feshie/sensors/README.md

sensors
=======
These feshie smarft sensors use an MCU (AVR) to interface to the actual sensors - and provide protocol buffer formatted data
