feshie/sensors/code/OneWire/README.md

Code from:
http://www.hacktronics.com/Tutorials/arduino-1-wire-tutorial.html
