feshie/sensors/pcbs/analog-interface.brd

## EAGLE design pcbs/analog-interface.brd (2014-09-02)

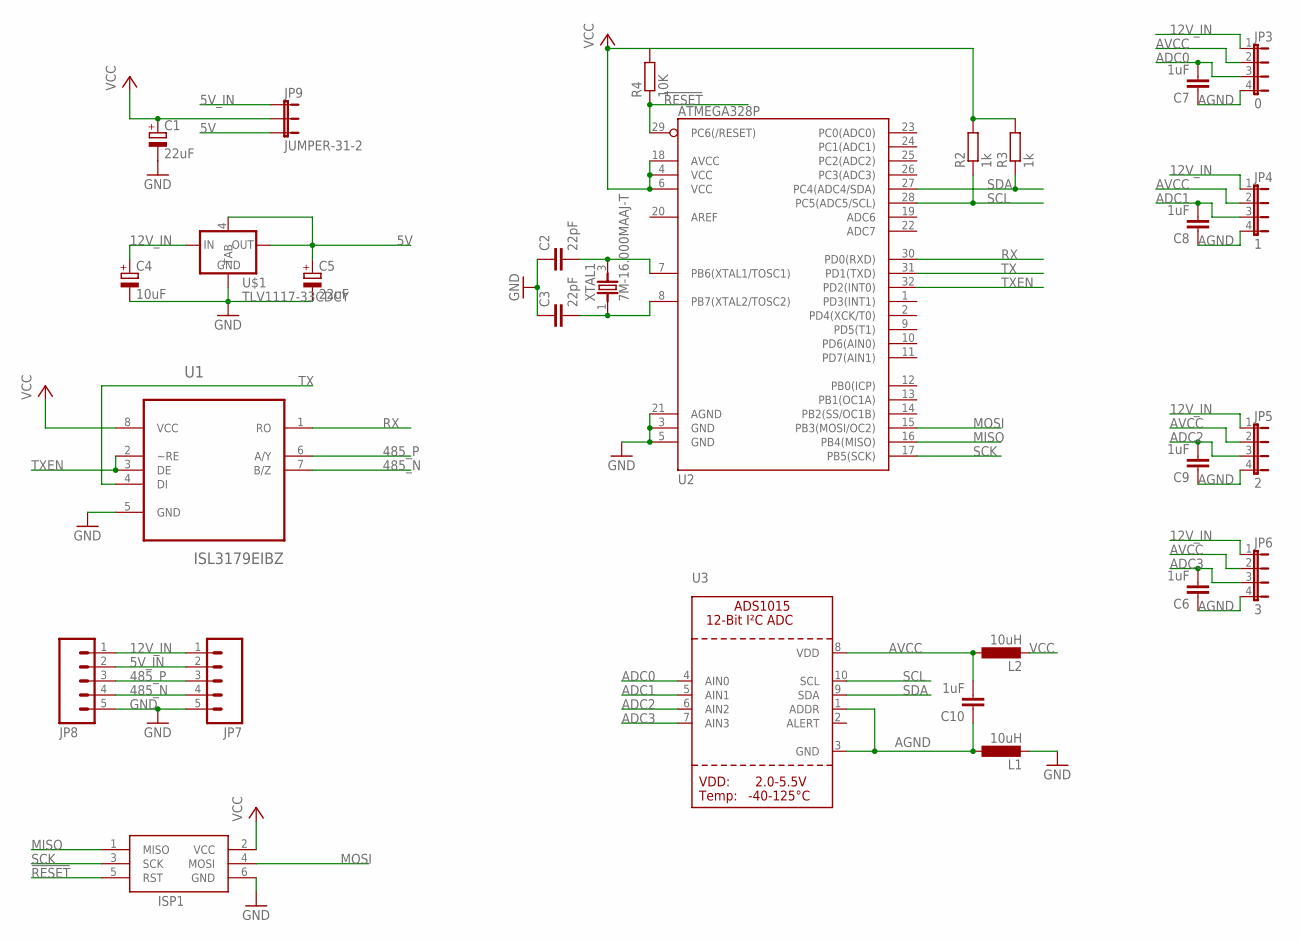
[picture p1: schematic analog-interface.sch]

Parts:
C1, C5: 22uF; A/3216-18R
C2, C3: 22pF; C0805
C4: 10uF; A/3216-18R
C6, C7, C8, C9, C10: 1uF; C0805
ISP1: AVRISP-6; AVRISP
JP3: 0; JP4
JP4: 1; JP4
JP5: 2; JP4
JP6: 3; JP4
JP7, JP8: M05PTH; 1X05
JP9: JUMPER-31-2; SJ_3_PASTE1&2
L1, L2: 10uH; L3216C
R2, R3: 1k; R0805
R4: 10K; R0805
U1: ISL3179EIBZ; SOIC127P600X175-8N
U2: ATMEGA328P; TQFP32-08
U3: ADC_ADS1015; MSOP10
U$1: TLV1117-33CDCY; SOT223
XTAL1: 7M-16.000MAAJ-T; TXC_7M-16.000MAAJ-T

Connections:
5V: C5.+, JP9.3, U$1.2 (OUT), U$1.4 (TAB)
5V_IN: JP7.2, JP8.2, JP9.1
12V_IN: C4.+, JP3.1, JP4.1, JP5.1, JP6.1, JP7.1, JP8.1, U$1.3 (IN)
485_N: JP7.4, JP8.4, U1.7 (B/Z)
485_P: JP7.3, JP8.3, U1.6 (A/Y)
!RESET: ISP1.5 (RST), R4.1, U2.29 (PC6(/RESET))
ADC0: C7.2, JP3.3, U3.4 (AIN0)
ADC1: C8.2, JP4.3, U3.5 (AIN1)
ADC2: C9.2, JP5.3, U3.6 (AIN2)
ADC3: C6.2, JP6.3, U3.7 (AIN3)
AGND: C6.1, C7.1, C8.1, C9.1, C10.1, JP3.4, JP4.4, JP5.4, JP6.4, L1.1, U3.1 (ADDR), U3.3 (GND)
AVCC: C10.2, JP3.2, JP4.2, JP5.2, JP6.2, L2.1, U3.8 (VDD)
GND: C1.-, C2.1, C3.1, C4.-, C5.-, ISP1.6 (GND), JP7.5, JP8.5, L1.2, U1.5 (GND), U2.3 (GND), U2.5 (GND), U2.21 (AGND), U$1.1 (GND)
MISO: ISP1.1 (MISO), U2.16 (PB4(MISO))
MOSI: ISP1.4 (MOSI), U2.15 (PB3(MOSI/OC2))
unnamed: C2.2, U2.7 (PB6(XTAL1/TOSC1)), XTAL1.3
unnamed: C3.2, U2.8 (PB7(XTAL2/TOSC2)), XTAL1.1
RX: U1.1 (RO), U2.30 (PD0(RXD))
SCK: ISP1.3 (SCK), U2.17 (PB5(SCK))
SCL: R2.1, U2.28 (PC5(ADC5/SCL)), U3.10 (SCL)
SDA: R3.1, U2.27 (PC4(ADC4/SDA)), U3.9 (SDA)
TX: U1.4 (DI), U2.31 (PD1(TXD))
TXEN: U1.2 (~RE), U1.3 (DE), U2.32 (PD2(INT0))
VCC: C1.+, ISP1.2 (VCC), JP9.2, L2.2, R2.2, R3.2, R4.2, U1.8 (VCC), U2.4 (VCC), U2.6 (VCC), U2.18 (AVCC)

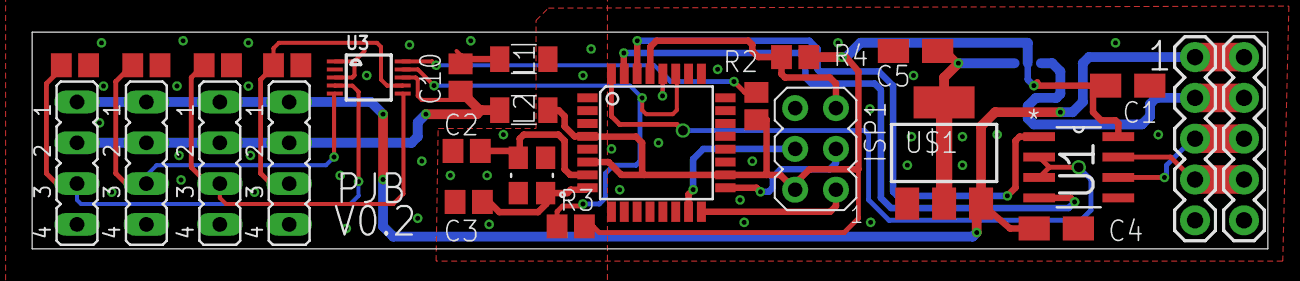
[picture p2: board analog-interface.brd from above]

Board: 2 copper layers, 76.9 x 13.5 mm, 28 parts (1 on the bottom side), 24 nets.
