feshie/sensors/pcbs/temp-accel-chain.brd

## EAGLE design pcbs/temp-accel-chain.brd (2014-07-10)

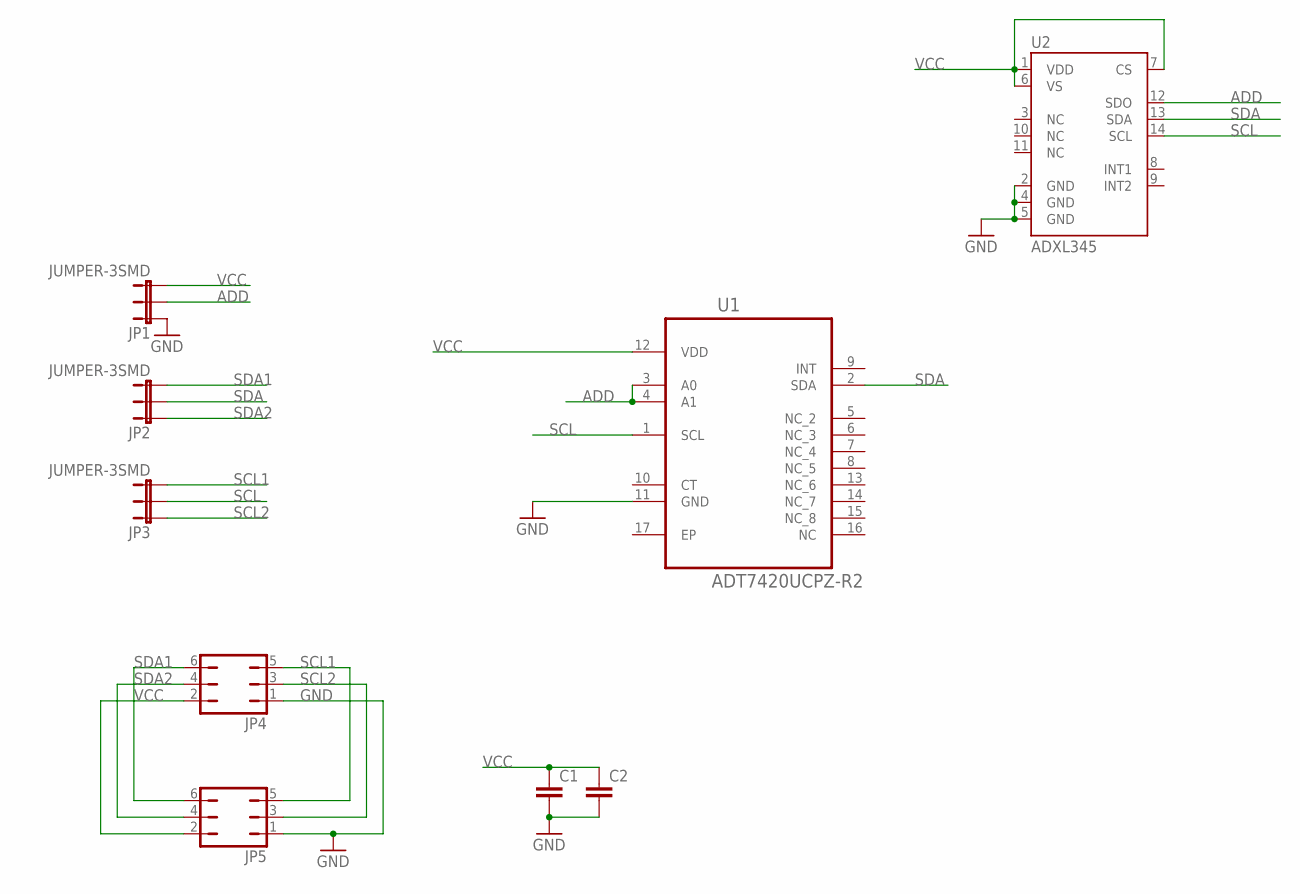
[picture p3: schematic temp-accel-chain.sch]

Parts:
C1, C2: C-EUC0805; C0805
JP1, JP2, JP3: JUMPER-3SMD; SJ_3
JP4, JP5: JP3Q
U1: ADT7420UCPZ-R2; QFN65P400X400X80-17N
U2: ADXL345; LGA14

Connections:
ADD: JP1.2, U1.3 (A0), U1.4 (A1), U2.12 (SDO)
GND: C1.2, C2.2, JP1.1, JP4.1, JP5.1, U1.11 (GND), U2.2 (GND), U2.4 (GND), U2.5 (GND)
SCL: JP3.2, U1.1 (SCL), U2.14 (SCL)
SCL1: JP3.3, JP4.5, JP5.5
SCL2: JP3.1, JP4.3, JP5.3
SDA: JP2.2, U1.2 (SDA), U2.13 (SDA)
SDA1: JP2.3, JP4.6, JP5.6
SDA2: JP2.1, JP4.4, JP5.4
VCC: C1.1, C2.1, JP1.3, JP4.2, JP5.2, U1.12 (VDD), U2.1 (VDD), U2.6 (VS), U2.7 (CS)

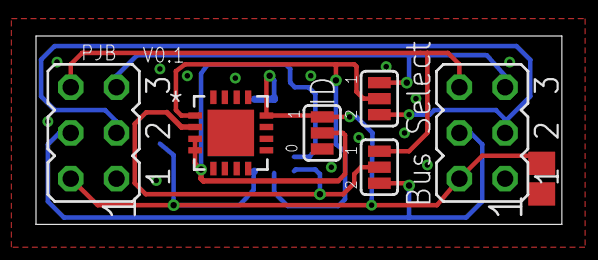
[picture p4: board temp-accel-chain.brd from above]

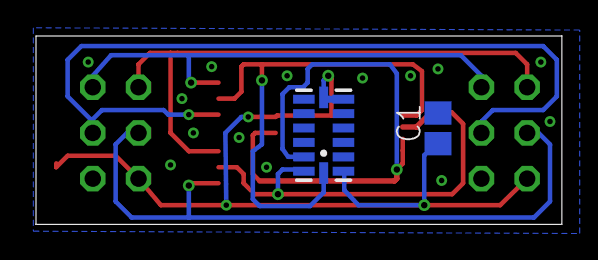
[picture p5: board temp-accel-chain.brd from below]

Board: 2 copper layers, 29.2 x 10.5 mm, 9 parts (2 on the bottom side), 9 nets.
