feshie/sensors/pcbs/mpx4115-breakout-throughhole.brd

## EAGLE design pcbs/mpx4115-breakout-throughhole.brd (2014-07-01)

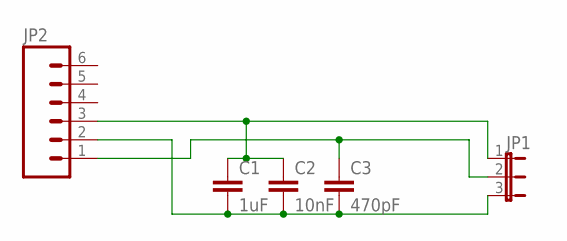
[picture p6: schematic mpx4115-breakout-throughhole.sch]

Parts:
C1: 1uF; C0805
C2: 10nF; C0805
C3: 470pF; C0805
JP1: JP2E; JP2
JP2: M06NO_SILK; 1X06_NO_SILK

Connections:
GND: C1.2, C2.2, C3.2, JP2.2
VCC: C1.1, C2.1, JP1.1, JP2.3
VOUT: C3.1, JP1.2, JP2.1

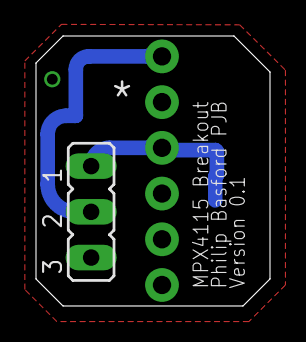
[picture p7: board mpx4115-breakout-throughhole.brd from above]

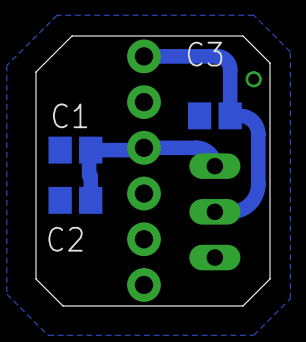
[picture p8: board mpx4115-breakout-throughhole.brd from below]

Board: 2 copper layers, 13.0 x 15.0 mm, 5 parts (3 on the bottom side), 3 nets.
