feshie/sensors/pcbs/mpx4115-breakout.brd

## EAGLE design pcbs/mpx4115-breakout.brd (2014-06-12)

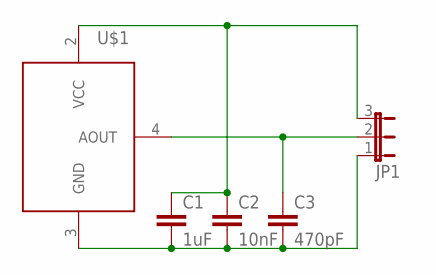
[picture p9: schematic mpx4115-breakout.sch]

Parts:
C1: 1uF; C0805
C2: 10nF; C0805
C3: 470pF; C0805
JP1: JP2E; JP2
U$1: MPX4115A

Connections:
AOUT: C3.1, JP1.2, U$1.4 (AOUT)
GND: C1.2, C2.2, C3.2, JP1.1, U$1.3 (GND)
VCC: C1.1, C2.1, JP1.3, U$1.2 (VCC)

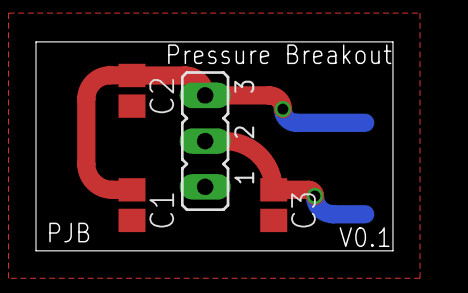
[picture p10: board mpx4115-breakout.brd from above]

Board: 2 copper layers, 19.8 x 11.6 mm, 5 parts (1 on the bottom side), 3 nets.
