feshie/sensors/pcbs/accel-chain.brd

## EAGLE design pcbs/accel-chain.brd (2014-05-12)

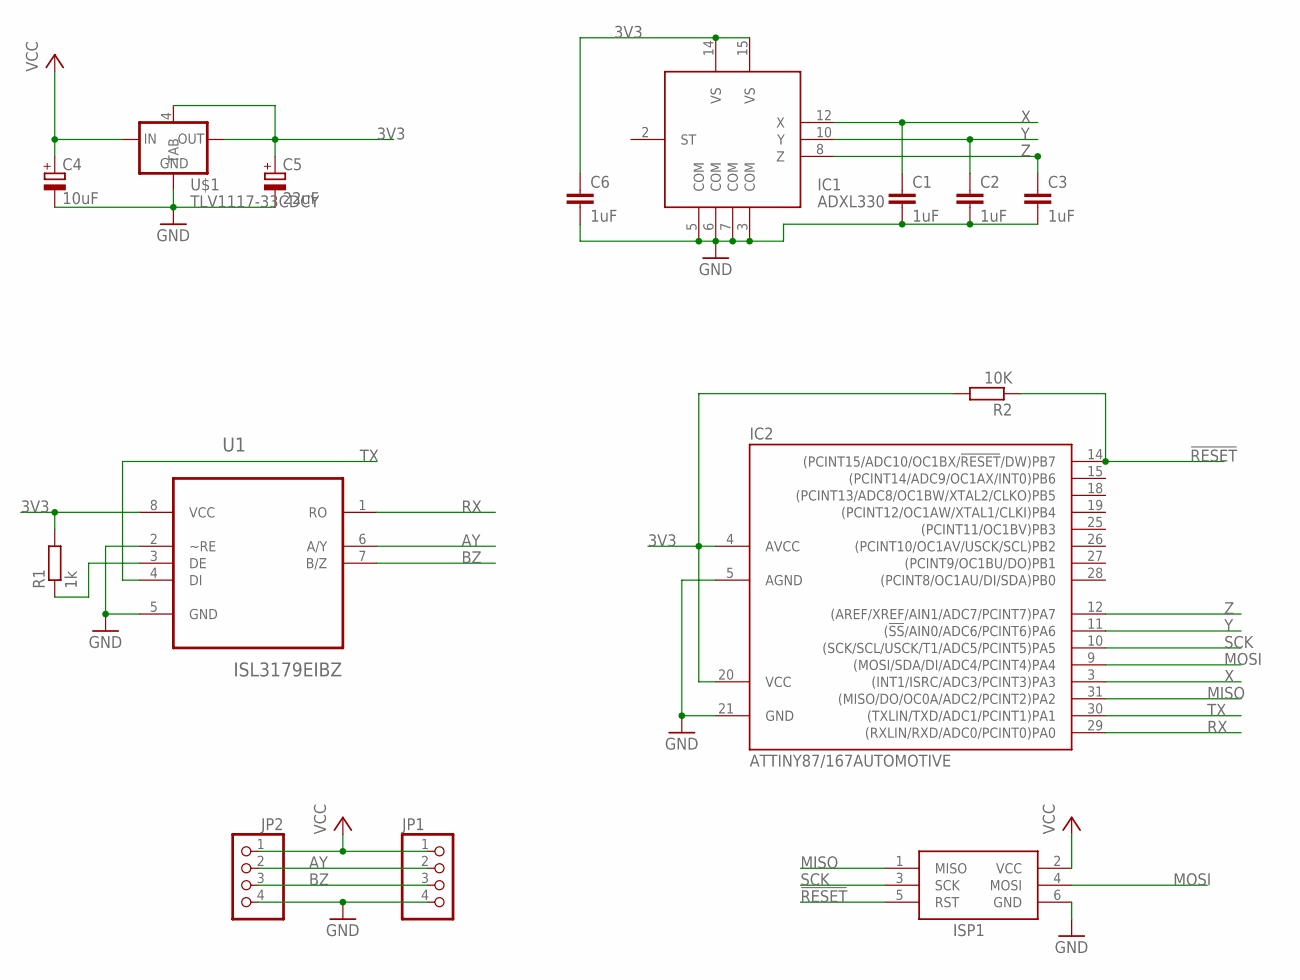
[picture p11: schematic accel-chain.sch]

Parts:
C1, C2, C3, C6: 1uF; C0805
C4: 10uF; A/3216-18R
C5: 22uF; A/3216-18R
IC1: ADXL330; LFCSP16
IC2: ATTINY87/167AUTOMOTIVE; MLF32
ISP1: AVRISP-6; AVRISP
JP1, JP2: PINHD-1X4; 1X04
R1: 1k; R0805
R2: 10K; R0805
U1: ISL3179EIBZ; SOIC127P600X175-8N
U$1: TLV1117-33CDCY; SOT223

Connections:
3V3: C5.+, C6.1, IC1.14 (VS), IC1.15 (VS), IC2.4 (AVCC), IC2.20 (VCC), R1.2, R2.2, U1.8 (VCC), U$1.2 (OUT), U$1.4 (TAB)
!RESET: IC2.14 ((PCINT15/ADC10/OC1BX/!RESET!/DW)PB7), ISP1.5 (RST), R2.1
AY: JP1.2, JP2.2, U1.6 (A/Y)
BZ: JP1.3, JP2.3, U1.7 (B/Z)
GND: C1.2, C2.2, C3.2, C4.-, C5.-, C6.2, IC1.3 (COM), IC1.5 (COM), IC1.6 (COM), IC1.7 (COM), IC2.5 (AGND), IC2.21 (GND), ISP1.6 (GND), JP1.4, JP2.4, U1.2 (~RE), U1.5 (GND), U$1.1 (GND)
MISO: IC2.31 ((MISO/DO/OC0A/ADC2/PCINT2)PA2), ISP1.1 (MISO)
MOSI: IC2.9 ((MOSI/SDA/DI/ADC4/PCINT4)PA4), ISP1.4 (MOSI)
unnamed: R1.1, U1.3 (DE)
RX: IC2.29 ((RXLIN/RXD/ADC0/PCINT0)PA0), U1.1 (RO)
SCK: IC2.10 ((SCK/SCL/USCK/T1/ADC5/PCINT5)PA5), ISP1.3 (SCK)
TX: IC2.30 ((TXLIN/TXD/ADC1/PCINT1)PA1), U1.4 (DI)
VCC: C4.+, ISP1.2 (VCC), JP1.1, JP2.1, U$1.3 (IN)
X: C1.1, IC1.12 (X), IC2.3 ((INT1/ISRC/ADC3/PCINT3)PA3)
Y: C2.1, IC1.10 (Y), IC2.11 ((!SS!/AIN0/ADC6/PCINT6)PA6)
Z: C3.1, IC1.8 (Z), IC2.12 ((AREF/XREF/AIN1/ADC7/PCINT7)PA7)

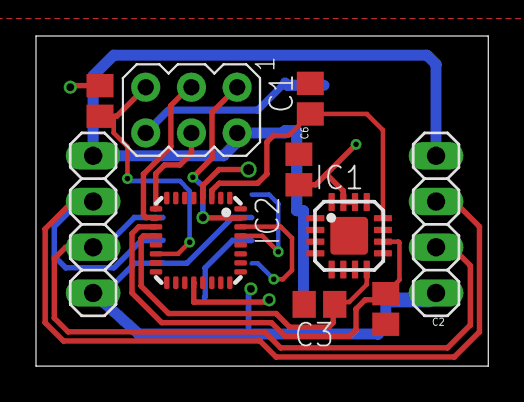
[picture p12: board accel-chain.brd from above]

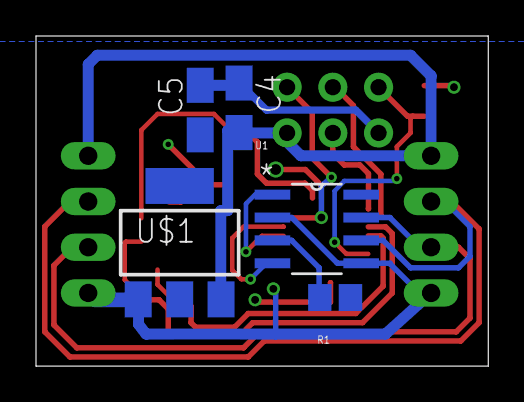
[picture p13: board accel-chain.brd from below]

Board: 2 copper layers, 25.1 x 18.3 mm, 15 parts (5 on the bottom side), 15 nets.
