feshie/sensors/(commit log)

2014-05-12 A board for the accel chain
    [accel-chain.brd, accel-chain.sch]
2014-05-16 a board containing an avr, programming header, rs485 driver. The I2C and 1W ports are broken out to headers making this suitable for the head of a chain
    [interface.brd, interface.sch]
2014-05-16 forgot i2c pullups
    [interface.brd, interface.sch]
2014-05-17 now uses an avr supported by arduino
    [interface.brd, interface.sch]
2014-06-08 added optional 3v3 reg
    [interface.brd, interface.sch]
2014-06-09 first version - no accel
    [temp-accel-chain.brd, temp-accel-chain.sch]
2014-06-09 silk screen worked on. drc fixed
    [temp-accel-chain.brd]
2014-06-09 now has 2 I2C busses
    [interface.brd, interface.sch]
2014-06-09 added 10ks to adress lines
    [temp-accel-chain.brd, temp-accel-chain.sch]
2014-06-10 temp i2c address either 00 or 11 thus saving a resistor
    [temp-accel-chain.brd, temp-accel-chain.sch]
2014-06-10 extended ground plane out
    [temp-accel-chain.brd]
2014-06-11 added accel to back and mostly routed
    [temp-accel-chain.brd, temp-accel-chain.sch]
2014-06-11 completely routed board
    [temp-accel-chain.brd, temp-accel-chain.sch]
2014-06-11 more silk screen stuff
    [interface.brd]
2014-06-11 breakout board for mpx4115 sensor with conditioning caps as reconmended in datasheet
    [mpx4115-breakout.brd, mpx4115-breakout.sch]
2014-06-12 Minor layout tweaks
    [mpx4115-breakout.brd]
2014-06-12 now called D-interface for digital
    [interface.brd]
2014-06-12 removed unneeded resistor on add select pins
    [temp-accel-chain.brd, temp-accel-chain.sch]
2014-06-12 first thoughts for analog interface board
    [analog-interface.brd, analog-interface.sch]
2014-06-18 track lengths now within 0.2% for rs485
    [interface.brd, interface.sch]
2014-06-18 done a lot of routing added vref chip
    [analog-interface.brd, analog-interface.sch]
2014-06-19 Minor DRC fixes
    [interface.brd]
2014-06-19 more minor DRC fixes
    [temp-accel-chain.brd]
2014-06-19 Moved PCBs into sub folder
    [accel-chain.brd, accel-chain.sch, analog-interface.brd, analog-interface.sch, interface.brd, interface.sch, mpx4115-breakout.brd, mpx4115-breakout.sch]
2014-06-19 added pull up to 1w
    [interface.brd, interface.sch]
2014-06-19 Will loop through and print the 1w temperature
2014-06-19 Now set up so that it can read through all devices by calling read_1W()
2014-06-20 minor changes to silk screen
    [interface.brd, temp-accel-chain.brd]
2014-06-23 stubs to test individual sensors
2014-06-23 laser width set
    [interface.brd, temp-accel-chain.brd]
2014-06-24 Accel reading using software I2C now works
2014-06-24 Added software I2C library
2014-06-24 Now uses external ADC and is long and thin. Possibly too long...
    [analog-interface.brd, analog-interface.sch]
2014-06-25 Now has seperate AGND and AVCC 12V available on ADC headers lots of vias A bit shorter
    [analog-interface.brd, analog-interface.sch]
2014-06-25 Added a couple of vias and Silk screen layer
    [analog-interface.brd]
2014-06-25 Now reads the temperature using the software I2C library
2014-06-25 doesn't need wire.h general tidyage
    [adx_stub_soft.ino]
2014-06-25 Pull ups added to I2C
    [analog-interface.brd, analog-interface.sch]
2014-06-30 first version of through hole mpx breakout
    [mpx4115-breakout-throughhole.brd, mpx4115-breakout-throughhole.sch]
2014-07-01 now with 6 holes for pressure sensor
    [mpx4115-breakout-throughhole.brd, mpx4115-breakout-throughhole.sch]
2014-07-01 simple stub file to show basics of reading a single ended ADC chanel
2014-07-02 Silk screen stuff
    [analog-interface.brd]
2014-07-10 cutter width set to size of lazer cutter
    [analog-interface.brd, interface.brd]
2014-07-24 Now reads 2 sensors
2014-07-31 Will print out a line containing all data from the chain
2014-08-02 Starting to work on final AVR sensor driver code
2014-08-10 Now also supports OW temperature spider
2014-09-02 ASCII table which loops forever and has the required pin for the RS485 command
2014-09-02 Now also prints the mode out
2014-09-02 Now uses more definitions from sensors.h
2014-09-02 debug output enabled now uses pin to control rs485
2014-09-02 Now has pin for rs485 tx enable
    [interface.brd, interface.sch]
2014-09-02 now has control of rx as well
    [interface.brd, interface.sch]
2014-09-02 Now has control of Tx/Rx for RS485 chip
    [analog-interface.brd, analog-interface.sch]
2014-09-02 Fixes #1 on both boards and version number updated
    [analog-interface.brd]
2014-10-05 Now goes back to start of printable characters rather than 0
2014-10-05 Now prints out in hex
2014-10-05 Now prints ID in hex
2014-10-08 sets the fuse so that the id persists between burnings
2014-10-08 Now has ADC for water pressure integrated
2014-10-08 Now toggles rs485 enable pin
